InvisibleBugMaker/Robot-Arm-Project/4.JPG

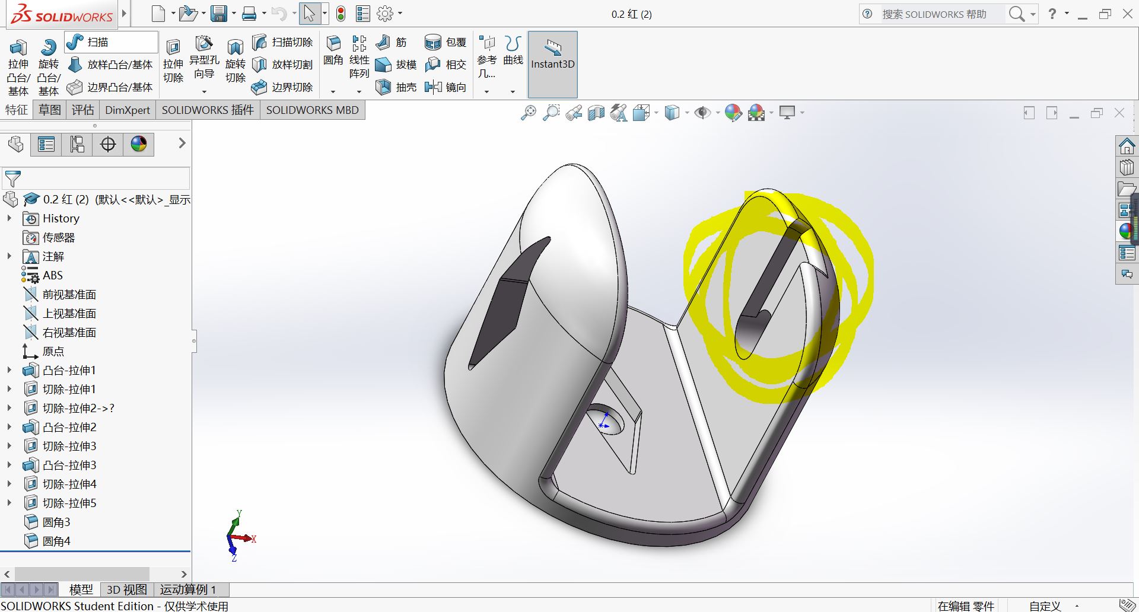
4.JPG
