InvisibleBugMaker/Robot-Arm-Project/微信图片_20171012031933.jpg

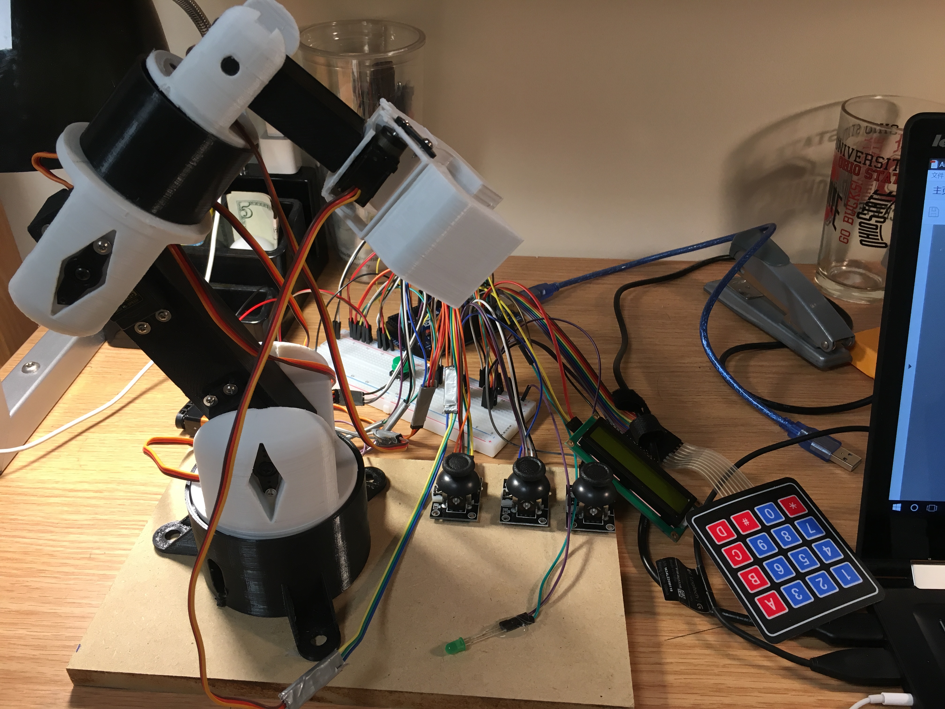
微信图片_20171012031933.jpg
