InvisibleBugMaker/Robot-Arm-Project/README.md

# Robot-Arm-Project
 6 DOF Robot Arm Project
