InvisibleBugMaker/Robot-Arm-Project/Prototype Lab Grading Rubric.pdf

## Mechanical Engineering 2900 Introduction to Design in Mechanical Engineering Prototype Lab Grading Rubric

### Name:

### Prototype Name:

| Possible Points | Earned Points

Physical Prototype Assessment

Final prototype components | 10
New actuator and new sensor | 2
Electrical and physical components | 2
Level of polish of finished prototype | 3
Complexity of programming | 12
Report Requirements | 31
Prototype Video | 5
Prototype Demonstration | 5
Total | 70
