InvisibleBugMaker/Robot-Arm-Project/Prototype Components.pdf

## Mechanical Engineering 2900 Introduction to Design in Mechanical Engineering Prototype Components

### Name:

### Prototype Name:

Component | New component?

Sensor or
actuator?

Electrical or
physical?

Final prototype?
TA signature required

If final prototype,
point value?

Total
