InvisibleBugMaker/Robot-Arm-Project/3D/2.STL

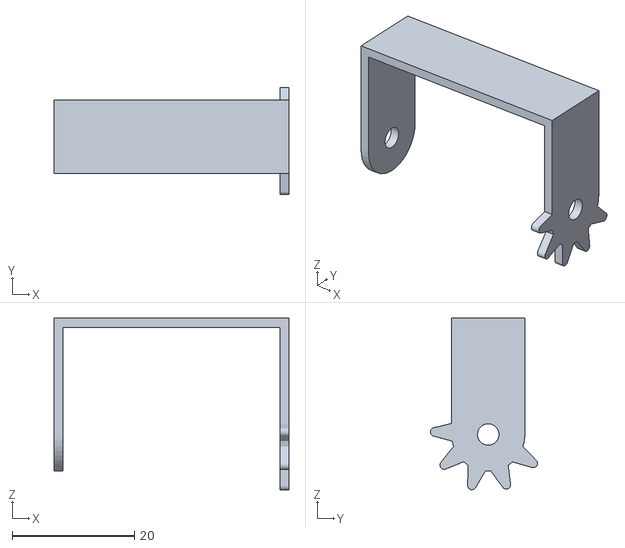
[picture p14: CAD file, 2021-12-16]
3D/2.STL
38.4 x 17.5 x 28.0
