InvisibleBugMaker/Robot-Arm-Project/3D/mg90s/Microservo halfhorn.SLDPRT

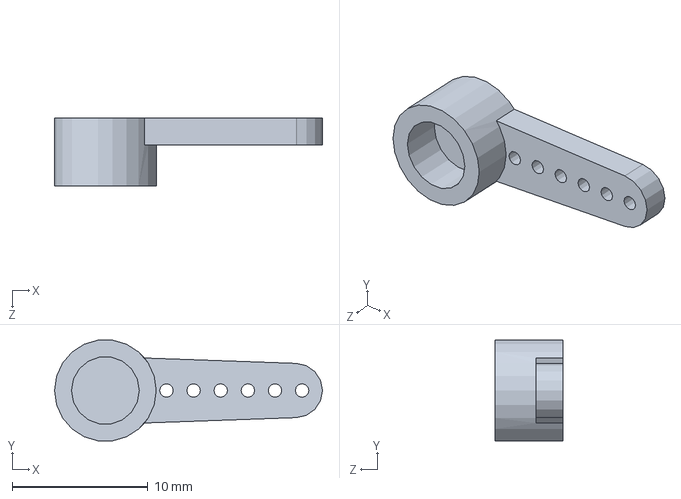
[picture p15: CAD file, 2021-12-16]
3D/mg90s/Microservo halfhorn.SLDPRT
19.8 x 7.42 x 5.00 mm
