InvisibleBugMaker/Robot-Arm-Project/3D/MG995/ShurikenStar6.SLDPRT

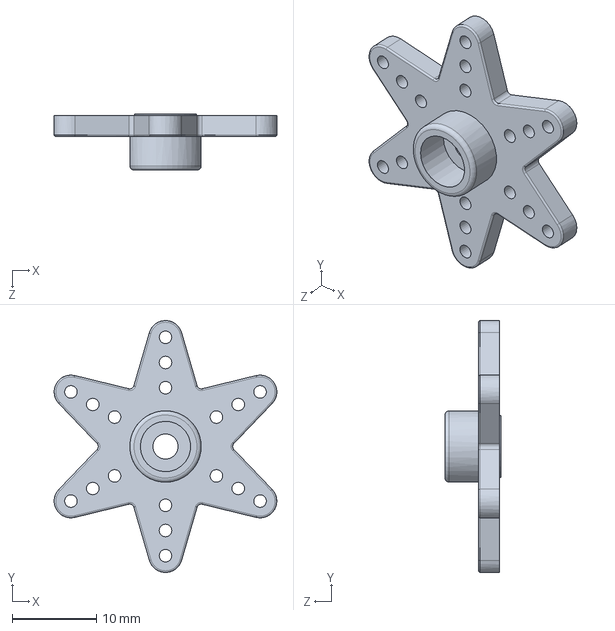
[picture p16: CAD file, 2021-12-16]
3D/MG995/ShurikenStar6.SLDPRT
26.5 x 30.0 x 6.70 mm
