InvisibleBugMaker/Robot-Arm-Project/3D/mg90s/Microservo horn.SLDPRT

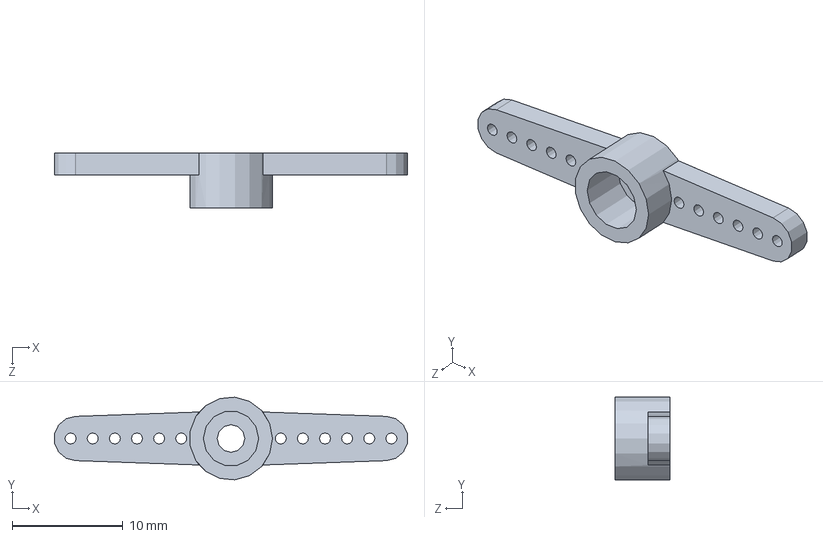
[picture p17: CAD file, 2021-12-16]
3D/mg90s/Microservo horn.SLDPRT
31.9 x 7.47 x 5.00 mm
