InvisibleBugMaker/Robot-Arm-Project/3D/MG995/ShurikenStarO.SLDPRT

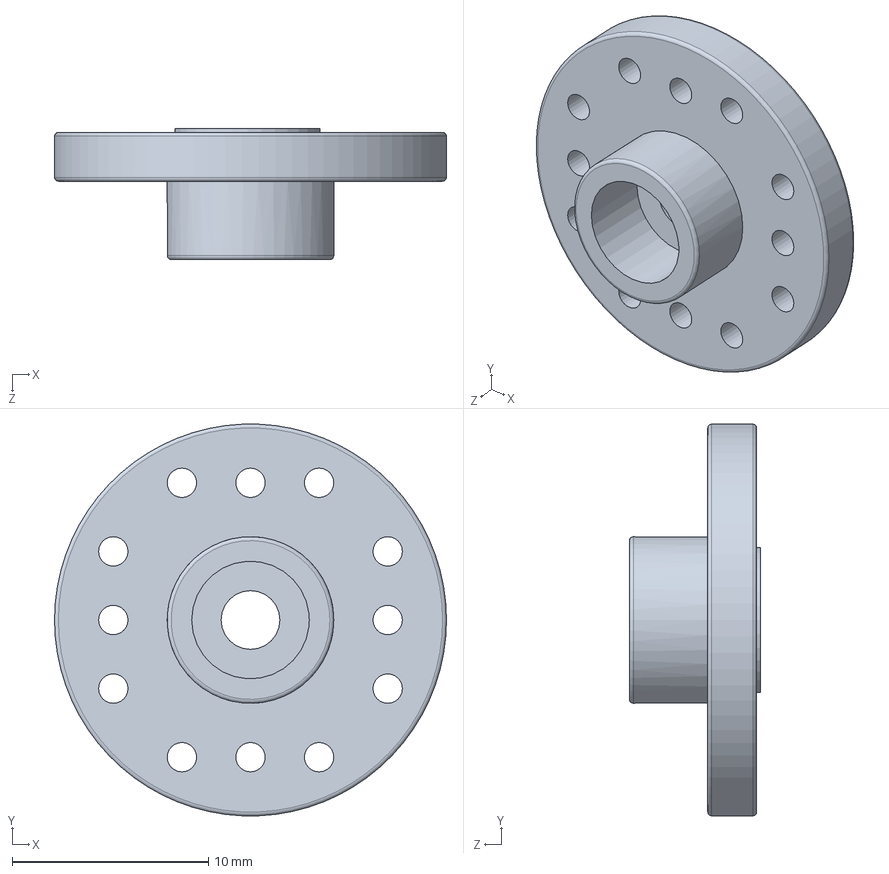
[picture p18: CAD file, 2021-12-16]
3D/MG995/ShurikenStarO.SLDPRT
20.0 x 20.0 x 6.70 mm
