InvisibleBugMaker/Robot-Arm-Project/3D/11.STL

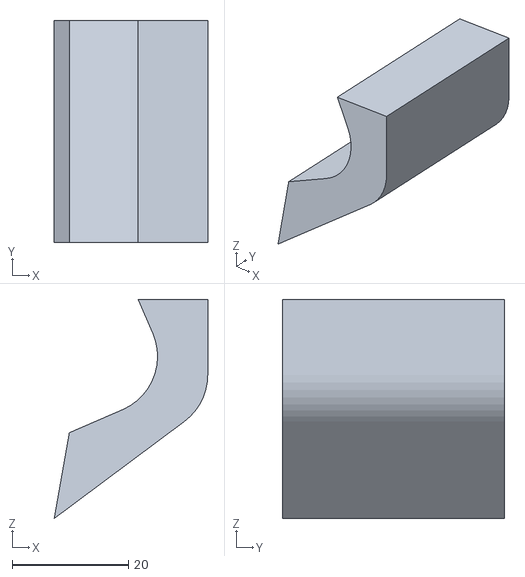
[picture p19: CAD file, 2021-12-16]
3D/11.STL
26.5 x 38.2 x 37.7
