InvisibleBugMaker/Robot-Arm-Project/3D/mg90s/MG90s_servo.SLDPRT

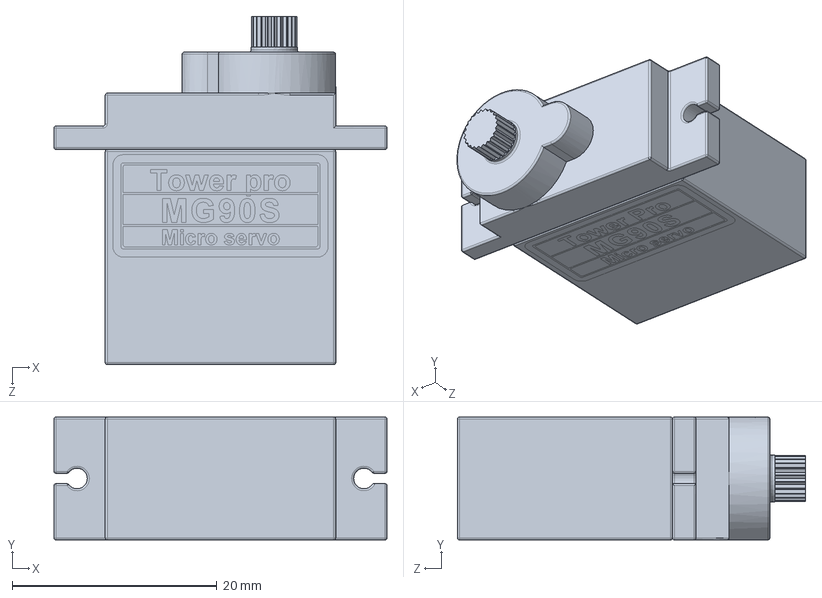
[picture p20: CAD file, 2021-12-16]
3D/mg90s/MG90s_servo.SLDPRT
32.5 x 12.0 x 34.0 mm
