InvisibleBugMaker/Robot-Arm-Project/3D/MG995/ShurikenStar.SLDPRT

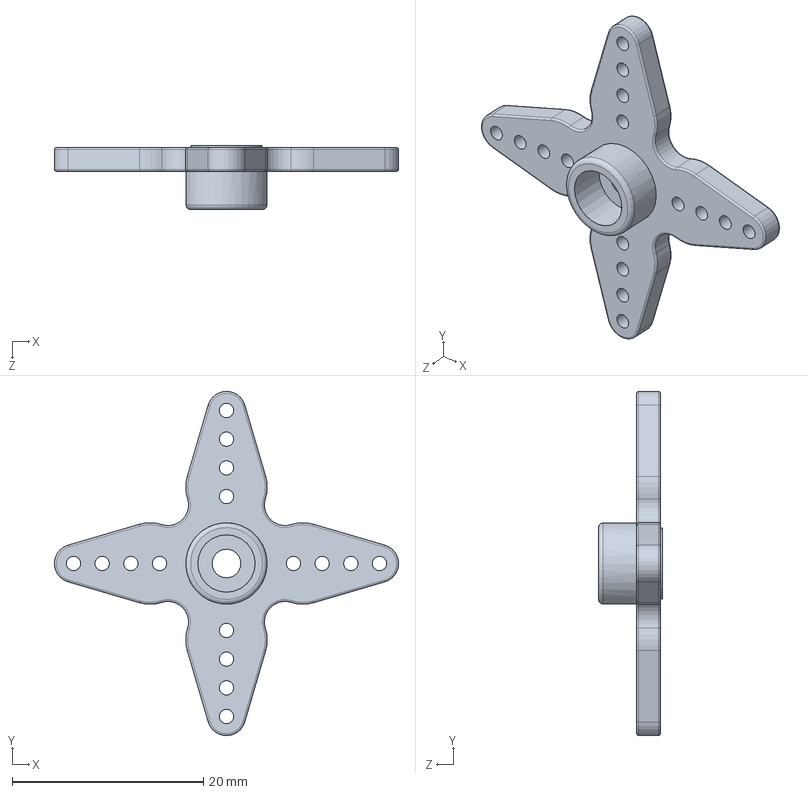
[picture p21: CAD file, 2021-12-16]
3D/MG995/ShurikenStar.SLDPRT
36.0 x 36.0 x 6.70 mm
