InvisibleBugMaker/Robot-Arm-Project/3D/8.STL

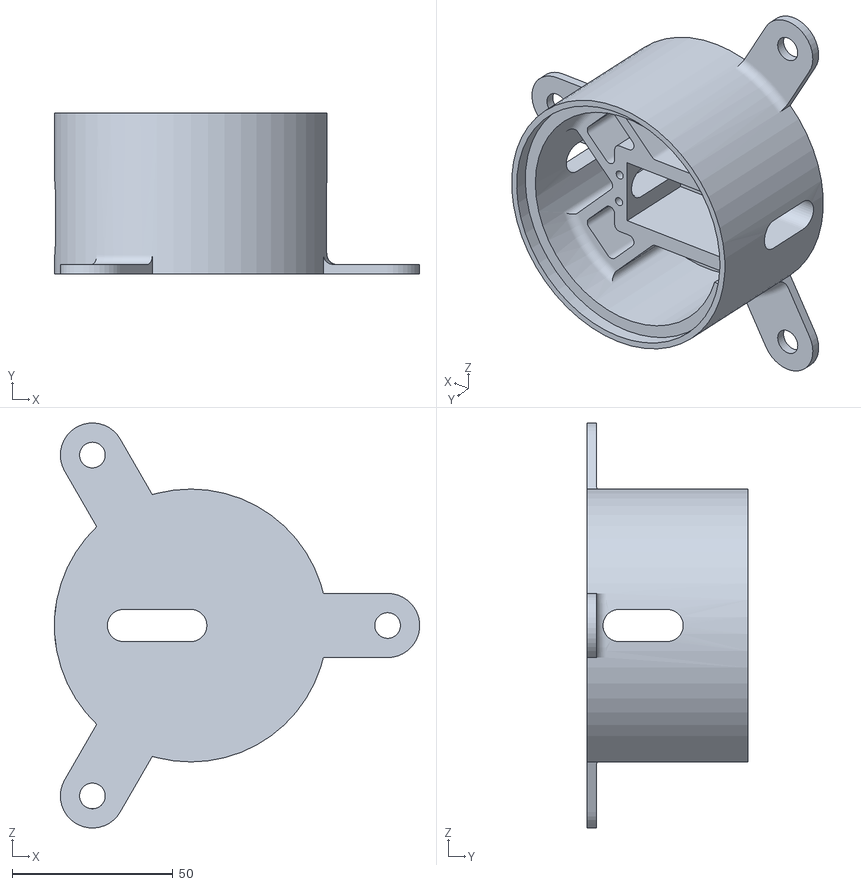
[picture p22: CAD file, 2021-12-16]
3D/8.STL
113.8 x 50.2 x 126.2
