InvisibleBugMaker/Robot-Arm-Project/3D/MG995/ShurikenStar2.SLDPRT

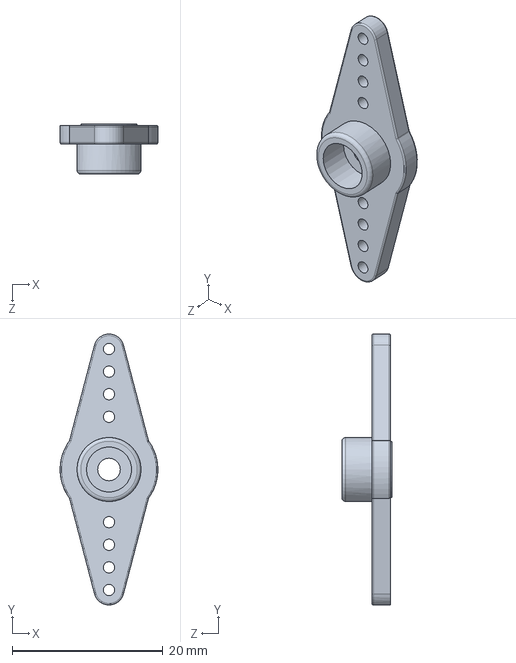
[picture p23: CAD file, 2021-12-16]
3D/MG995/ShurikenStar2.SLDPRT
13.0 x 36.0 x 6.70 mm
