InvisibleBugMaker/Robot-Arm-Project/3D/MG995/TowerProMG995.SLDPRT

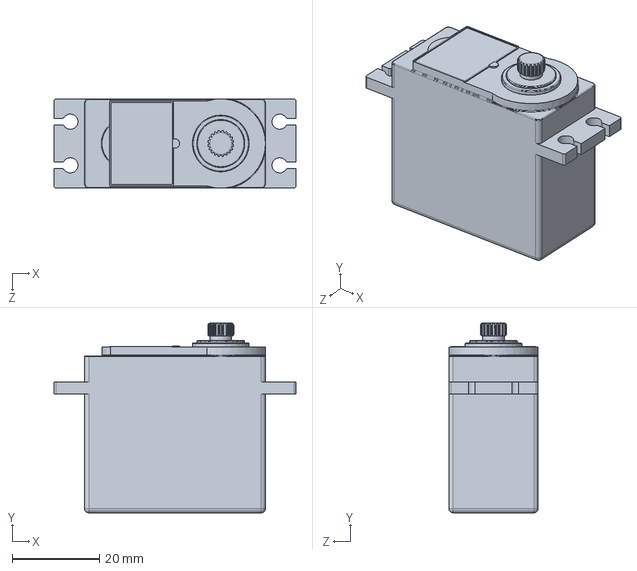
[picture p24: CAD file, 2021-12-16]
3D/MG995/TowerProMG995.SLDPRT
55.5 x 43.5 x 20.5 mm
