InvisibleBugMaker/Robot-Arm-Project/3D/0.1 红.SLDPRT

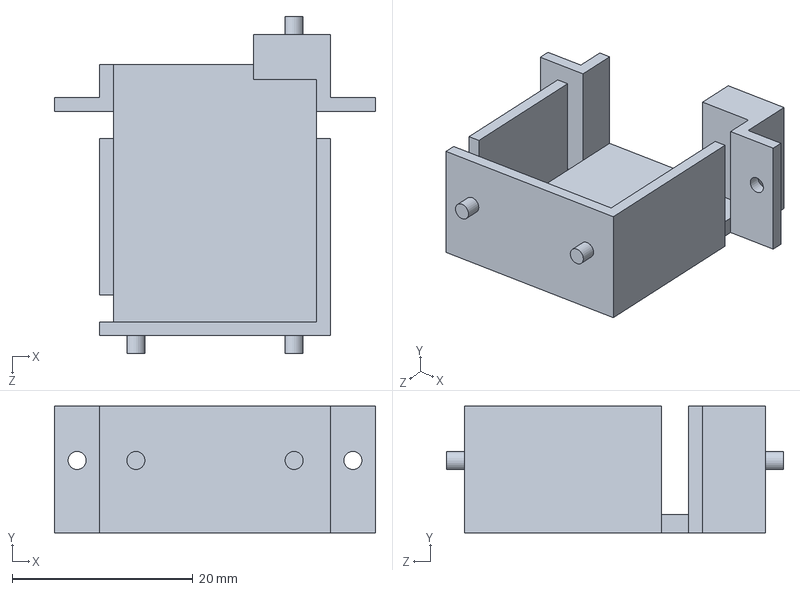
[picture p25: CAD file, 2021-12-16]
3D/0.1 红.SLDPRT
35.5 x 14.0 x 37.3 mm
