InvisibleBugMaker/Robot-Arm-Project/3D/1.STL

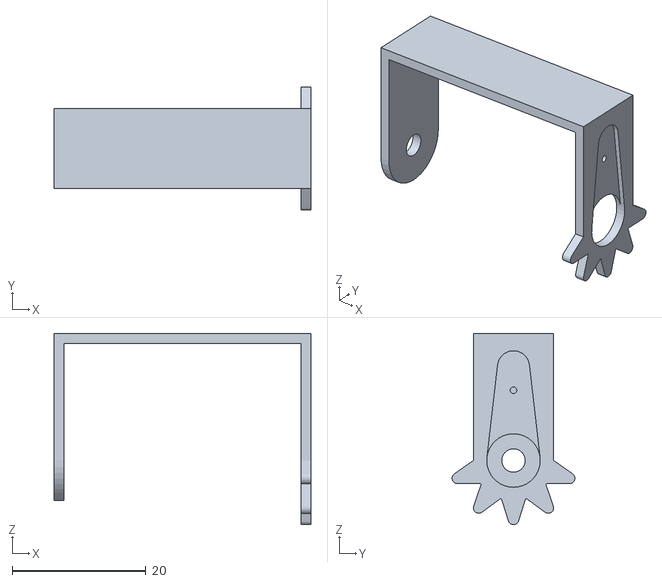
[picture p26: CAD file, 2021-12-16]
3D/1.STL
38.4 x 18.4 x 28.6
