InvisibleBugMaker/Robot-Arm-Project/3D/9.STL

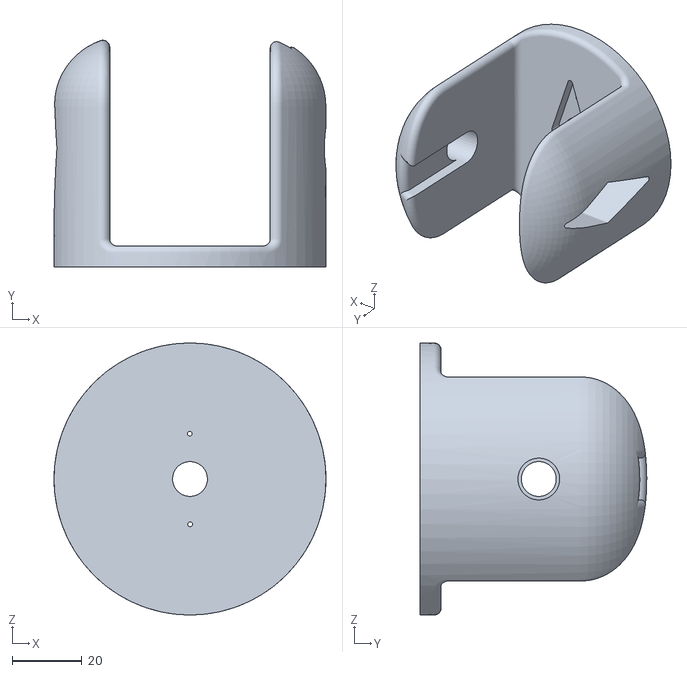
[picture p27: CAD file, 2021-12-16]
3D/9.STL
78.0 x 65.0 x 78.0
