InvisibleBugMaker/Robot-Arm-Project/3D/6.STL

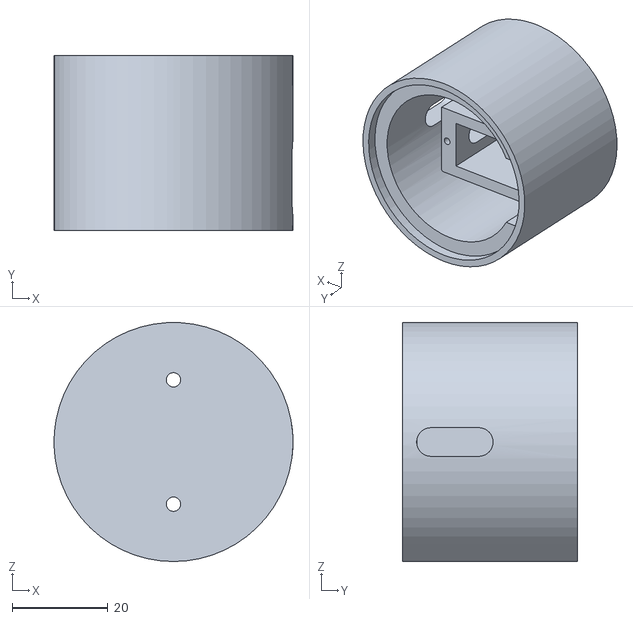
[picture p28: CAD file, 2021-12-16]
3D/6.STL
50.0 x 36.5 x 50.0
