InvisibleBugMaker/Robot-Arm-Project/3D/5.STL

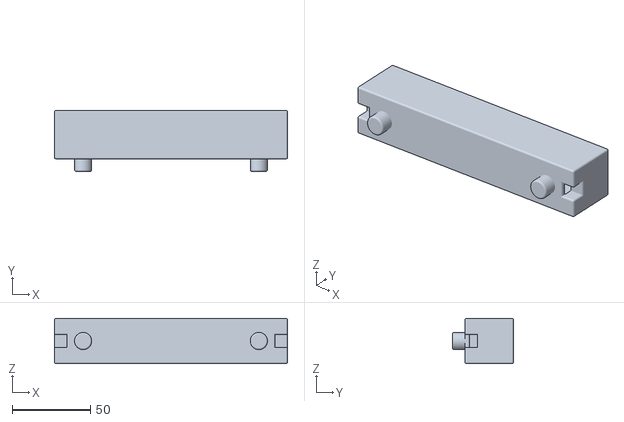
[picture p29: CAD file, 2021-12-16]
3D/5.STL
149.0 x 39.0 x 29.0
