InvisibleBugMaker/Robot-Arm-Project/3D/3.STL

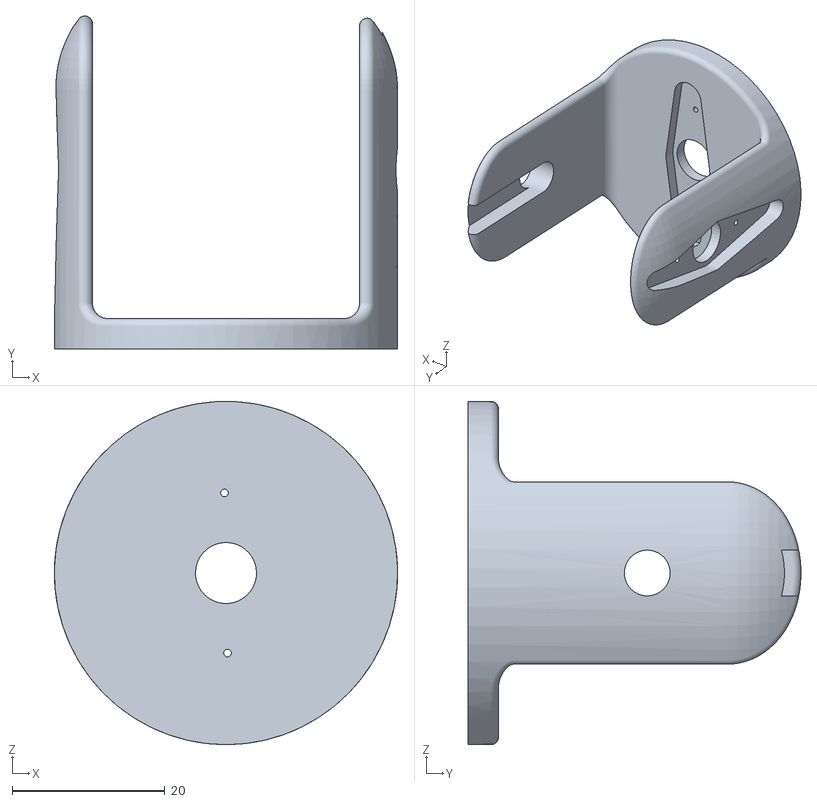
[picture p30: CAD file, 2021-12-16]
3D/3.STL
45.0 x 43.7 x 45.0
