InvisibleBugMaker/Robot-Arm-Project/3D/4.STL

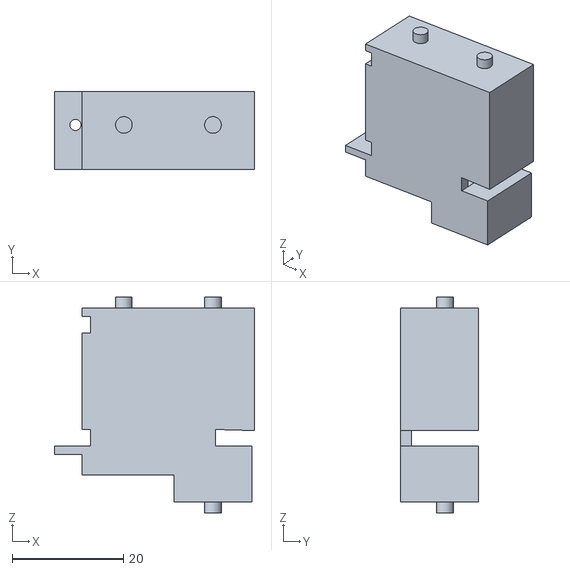
[picture p31: CAD file, 2021-12-16]
3D/4.STL
36.0 x 14.0 x 38.8
