InvisibleBugMaker/Robot-Arm-Project/3D/10.STL

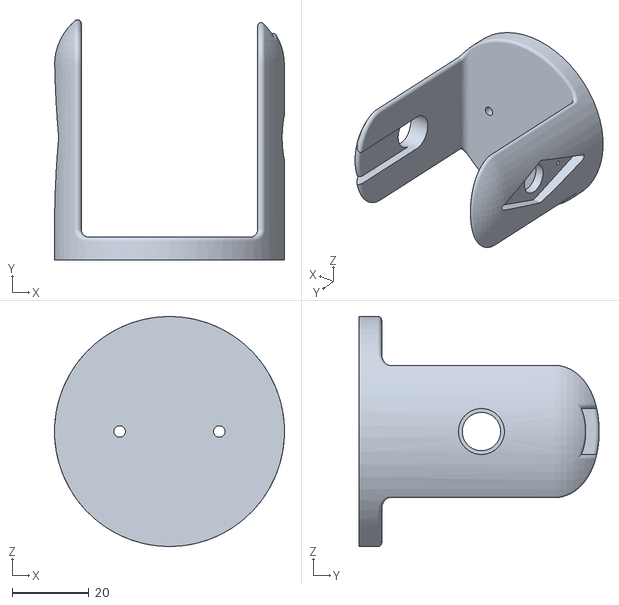
[picture p32: CAD file, 2021-12-16]
3D/10.STL
60.0 x 62.7 x 60.0
