InvisibleBugMaker/Robot-Arm-Project/3D/7.STL

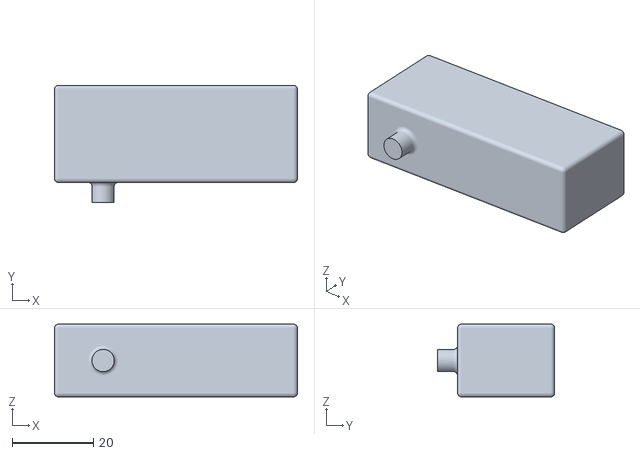
[picture p33: CAD file, 2021-12-16]
3D/7.STL
60.0 x 29.0 x 18.0
