InvisibleBugMaker/Robot-Arm-Project/(list of files, cad)

Other CAD files:
3D/0.2 红 2个.SLDPRT
3D/0.2 黑.SLDPRT
3D/0.2 红 (3).SLDPRT
3D/0.2 红 (2).SLDPRT
3D/0.1 红 (2).SLDPRT
3D/0.1 红 (3).SLDPRT
3D/0.1 红 (4).SLDPRT
3D/0.2 黑 (2).SLDPRT
3D/0.2 黑 (3).SLDPRT
3D/0.2 黑 (4).SLDPRT
