InvisibleBugMaker/Robot-Arm-Project/(list of files, drawings)

Other design files:
circuit/yuanjian/11.fzz
